siglabsoss/gravpower/ASSY/BOM/Bill of Materials-gravpower.xls

Designator | Description | Manufacturer | Manufacturer P/N | Quantity
C1, C9 | Ceramic Capacitor 47nF ±10% 100V X7R 0805 | Vishay | VJ0805Y473KXB | 2.0
C2, C3, C4, C5, C6, C7, C8 | Ceramic Capacitor 22uF ±20% 100V X7S Stacked | TDK | CKG57NX7S2A226M500JJ | 7.0
C10, C12, C24, C26, C38, C40, C51, C53 | Ceramic Capacitor 1uF ±10% 10V X5R 0402 | Murata | GRM155R61A105KE15 | 8.0
C11, C25, C39, C52 | Ceramic Capacitor 4.7uF ±10% 25V X5R 0603 | Samsung | CL10A475KA8NQNC | 4.0
C13, C14, C15, C16, C29, C30, C43 | Ceramic Capacitor 22uF ±10% 25V X7R 1210 | Murata | GRM32ER71E226KE15 | 7.0
C17, C18, C31, C32, C41, C42 | Tantalum Capacitor 330uF ±10% 10V 2917 | AVX | TPSE337K010R0050 | 6.0
C19, C33, C46, C60 | Ceramic Capacitor 100pF ±1% 50V NP0 0402 | Murata | GRM1555C1H101FA01D | 4.0
C20, C34, C47, C61 | Ceramic Capacitor 100pF ±10% 50V C0G 0402 | Vishay | VJ0402A101KXA | 4.0
C21, C35, C48, C62 | Ceramic Capacitor 1nF ±5% 50V NP0 0402 | Murata | GRM1555C1H102JA01 | 4.0
C22, C36, C49, C63 | Ceramic Capacitor 2.2nF ±5% 25V NP0 0402 | Kemet | C0402C222J3GACTU | 4.0
C23, C37, C50, C64 | Ceramic Capacitor 470pF ±5% 50V X7R 0402 | Murata | GRM155R71H471JA01 | 4.0
C27, C28, C44, C45, C54, C55 | Ceramic Capacitor 22uF ±20% 50V X7S Stacked | TDK | CKG57NX7S1H226M500JJ | 6.0
C56, C57, C58, C59 | Aluminum Electrolytic Capacitor 100uF ±20% 50V | Panasonic | EEE-FTH101XAP | 4.0
D1 | TVS Diode 70V/100V SMA | Diodes Inc | SMAT70A-13-F | 1.0
D2 | Zener Diode 12V 370mW SOD123 | Diodes Inc | DDZ12BQ-7 | 1.0
D3 | TVS Diode 24V/38.9V SMA | Diodes Inc | SMAJ24A-13-F | 1.0
D4, D6, D8, D10 | Schottky Diode 80V 250mA SOD323 | Diodes Inc | 1N4448HWS-7-F | 4.0
D5, D7, D9, D11 | Schottky Diode 200V 10A SMD | Diodes Inc | SBR10U200P5-13 | 4.0
L1, L3, L5, L7 | Inductor 33uH ±10% 500mA SMD | Coilcraft | ME3220-333KL | 4.0
L2 | Inductor 4.7uH,10.5A(sat), SMD | Coilcraft | XAL6060-472ME | 1.0
L4 | Inductor 10uH, 22A(sat), SMD | Pulse Electronics Power | PA4344.103ANLT | 1.0
L6 | Inductor 33uH,3.7A(sat), SMD | Coilcraft | XAL6060-333ME | 1.0
L8 | Inductor 47uH, 8A(sat), SMD | Eaton | HCM1A1707-470-R | 1.0
P1 | 2.5mm pitch 8-position connector | JST | B8B-XH-A | 1.0
P2 | 2.5mm pitch 4-position connector | JST | B4B-XH-A | 1.0
P3, P4 | 2.5mm pitch 5-position connector | JST | B5B-XH-A | 2.0
Q1, Q2, Q3, Q4, Q5, Q6, Q7, Q8, Q9, Q10 | MOSFET N-Channel Enhancement Mode | Infineon | BSC190N15NS3, BSC190N15NS3, BSC050NE2LS, BSC050NE2LS, BSC190N15NS3, BSC190N15NS3, BSC190N15NS3, BSC190N15NS3, BSC190N15NS3, BSC190N15NS3 | 10.0
R1 | Thin Film Resistor 10 Ohm ±1% 0402 | Vishay | MCS04020C1009FE000 | 1.0
R2 | Thin Film Resistor 10k +/-1% SMD 0805 | Yageo | RC0805FR-0710KL | 1.0
R3 | Thin Film Resistor 1k +/-1% SMD 0805 | Yageo | RC0805FR-071KL | 1.0
R4 | Current Sense Resistor 8 mOhms +/-1% SMD 4-Terminal | Susumu | KRL3216T4A-M-R008-F | 1.0
R5 | Thin Film Resistor 2.8k +/-0.1% SMD 0805 | Yageo | RT0805BRD072K8L | 1.0
R6 | Thin Film Resistor 39k +/-0.5% SMD 0402 | Susumu | RR0510P-393-D | 1.0
R7 | Thin Film Resistor 1.37k +/-0.1% SMD 0805 | Yageo | RT0805BRD071K37L | 1.0
R8, R14, R20, R30 | Thick Film Resistor 22.1k ±1% 0402 | Panasonic | ERJ-2RKF2212X | 4.0
R9, R15, R21, R31 | Thick Film Resistor 26.7k ±1% 0402 | Panasonic | ERJ-2RKF2672X | 4.0
R10 | Current Sense Resistor 3 mOhms +/-1% SMD 4-Terminal | Susumu | KRL3216T4A-M-R003-F | 1.0
R11, R17 | Thin Film Resistor 6.8k +/-0.1% SMD 0805 | Susumu | RG2012P-682-B-T5 | 2.0
R12 | Thin Film Resistor 75k +/-0.5% SMD 0402 | Susumu | RR0510P-753-D | 1.0
R13, R19 | Thin Film Resistor 2k +/-0.5% SMD 0402 | Susumu | RR0510P-202-D | 2.0
R16 | Current Sense Resistor 100 mOhms +/-1% SMD 4-Terminal | Susumu | KRL3216T4A-M-R100-F | 1.0
R18 | Thin Film Resistor 22k +/-0.5% SMD 0402 | Susumu | RR0510P-223-D | 1.0
R22 | Thin Film Resistor 430k +/-0.1% SMD 0805 | Yageo | RT0805BRD07430KL | 1.0
R23 | Thin Film Resistor 357k +/-0.1% SMD 0805 | Yageo | RT0805BRD07357KL | 1.0
R24 | Current Sense Resistor 9 mOhms +/-1% SMD 4-Terminal | Susumu | KRL3216T4A-M-R009-F | 1.0
R25 | Thick Film Resistor 10k ±1% 0.1W 50V 0402 | Panasonic | ERJ-2RKF1002X | 1.0
R26 | Thin Film Resistor 15k +/-0.1% SMD 0805 | Susumu | RG2012P-153-B-T5 | 1.0
R27 | Thin Film Resistor 255k +/-0.1% SMD 0805 | Vishay | PTN0805E2553BST1 | 1.0
R28 | Thin Film Resistor 49.9k +/-0.5% SMD 0402 | Susumu | RR0510P-4992-D | 1.0
R29 | Thin Film Resistor 11.5k +/-0.1% SMD 0805 | Yageo | RT0805BRD0711K5L | 1.0
TP1, TP2, TP3, TP4, TP5, TP6, TP7, TP8, TP9 | Test Point SMD | Keystone | 5015 | 9.0
U1 | Ideal Diode Controller | Linear Technology | LTC4359HMS8 | 1.0
U2, U3, U4, U5 | Synchronous Regulator Controller | Linear Technology | LT3840EUFE | 4.0
