siglabsoss/gravpower/SCH/GravPower_SCH.PDF

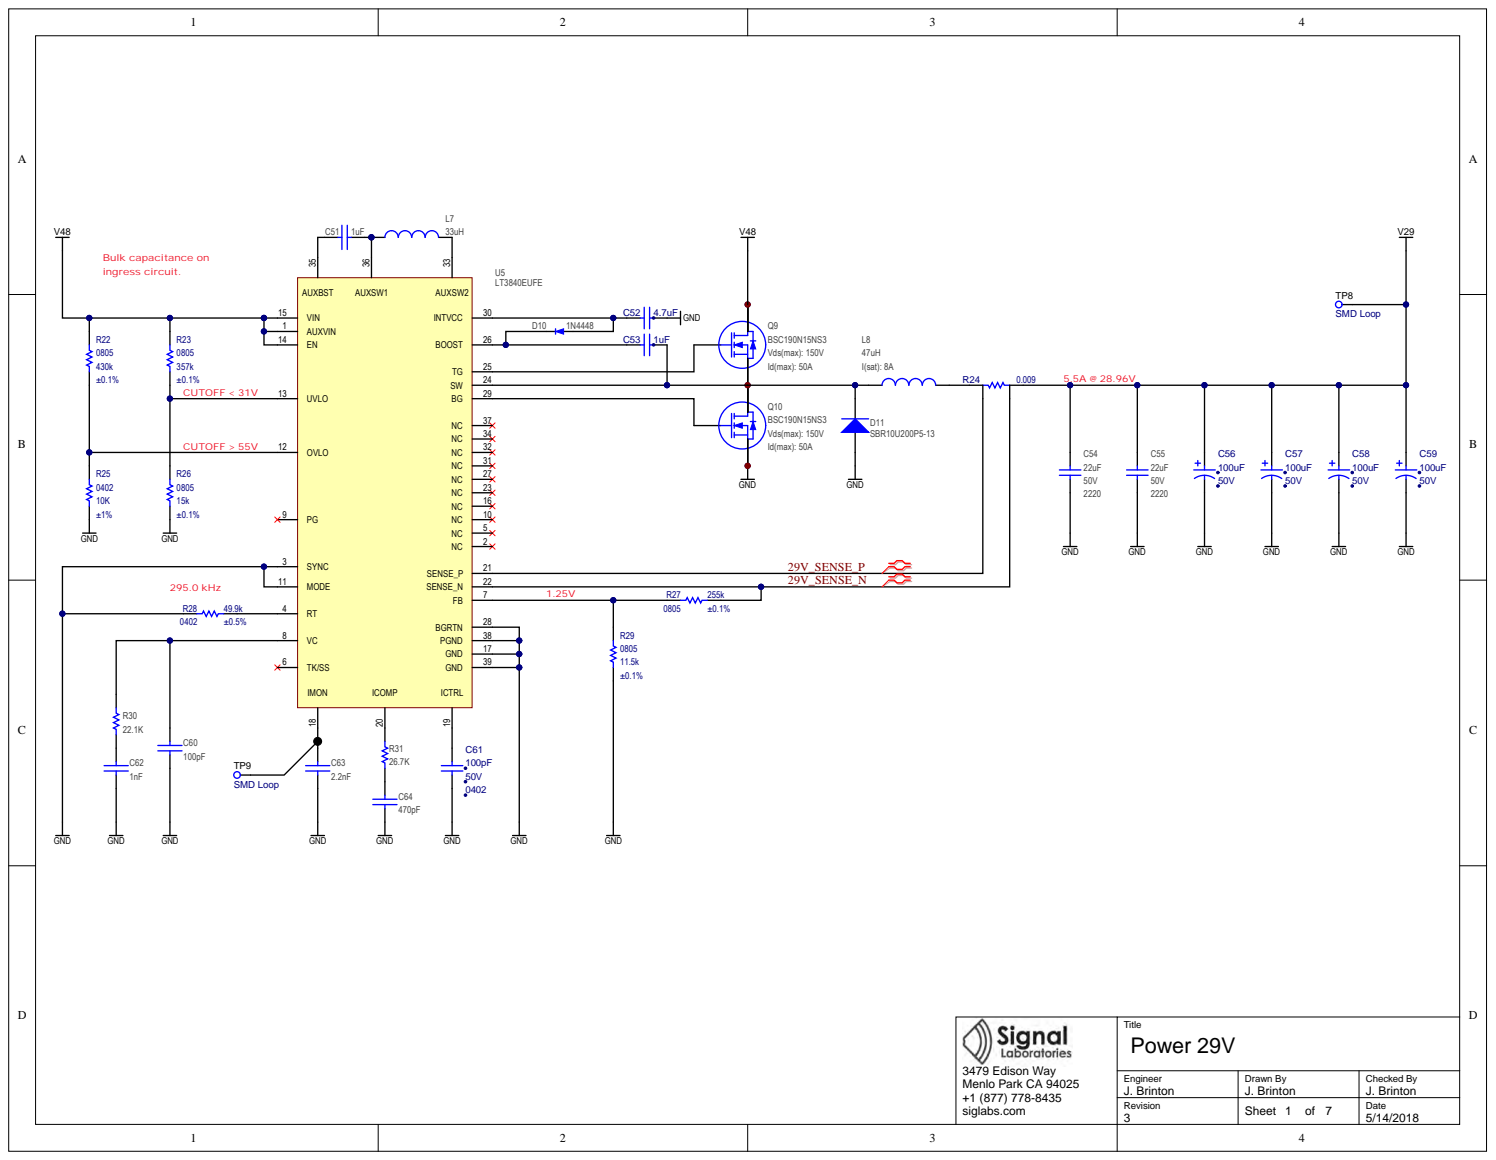
[picture p1: page 1]

R28 49.9k 0402 ±0.5% | MODE 11

3479 Edison Way Menlo Park CA 94025 +1 (877) 778-8435 siglabs.com | Title Power 29V

Engineer J. Brinton | Drawn By J. Brinton | Checked By J. Brinton

of 7 Revision 3 | 5/14/2018 Sheet 1 Date

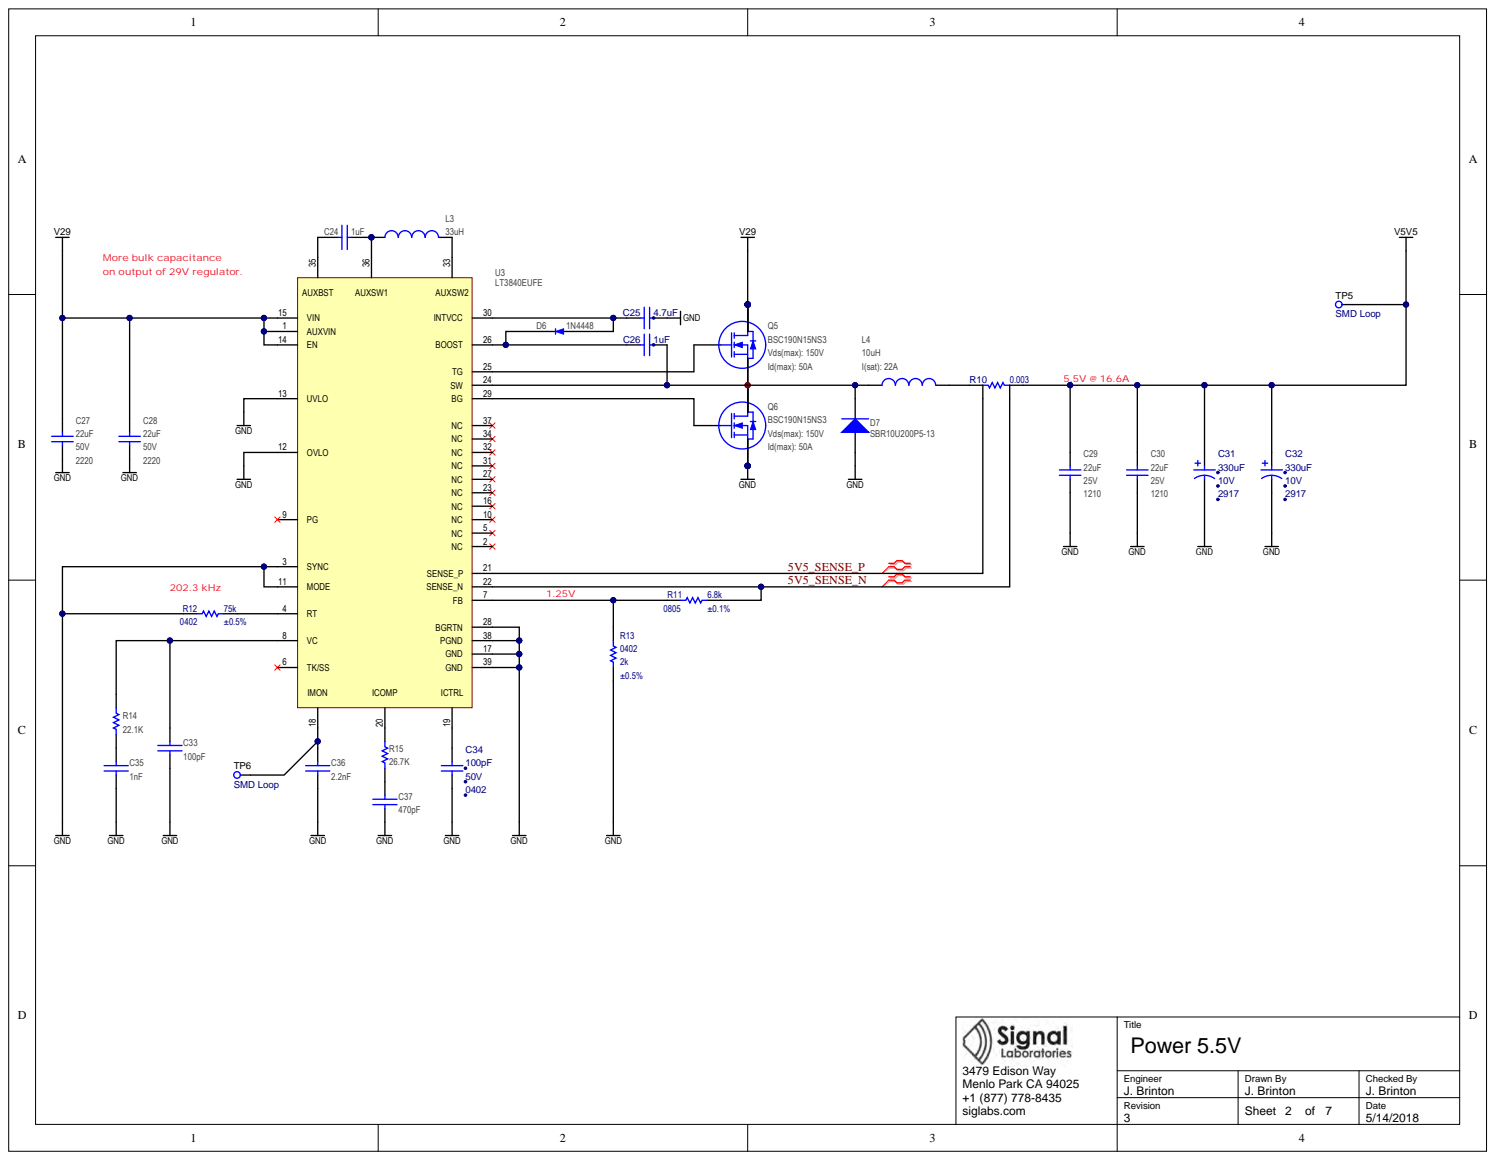
[picture p2: page 2]

More bulk capacitance
on output of 29V regulator.

R12 75k 0402 ±0.5% | MODE 11

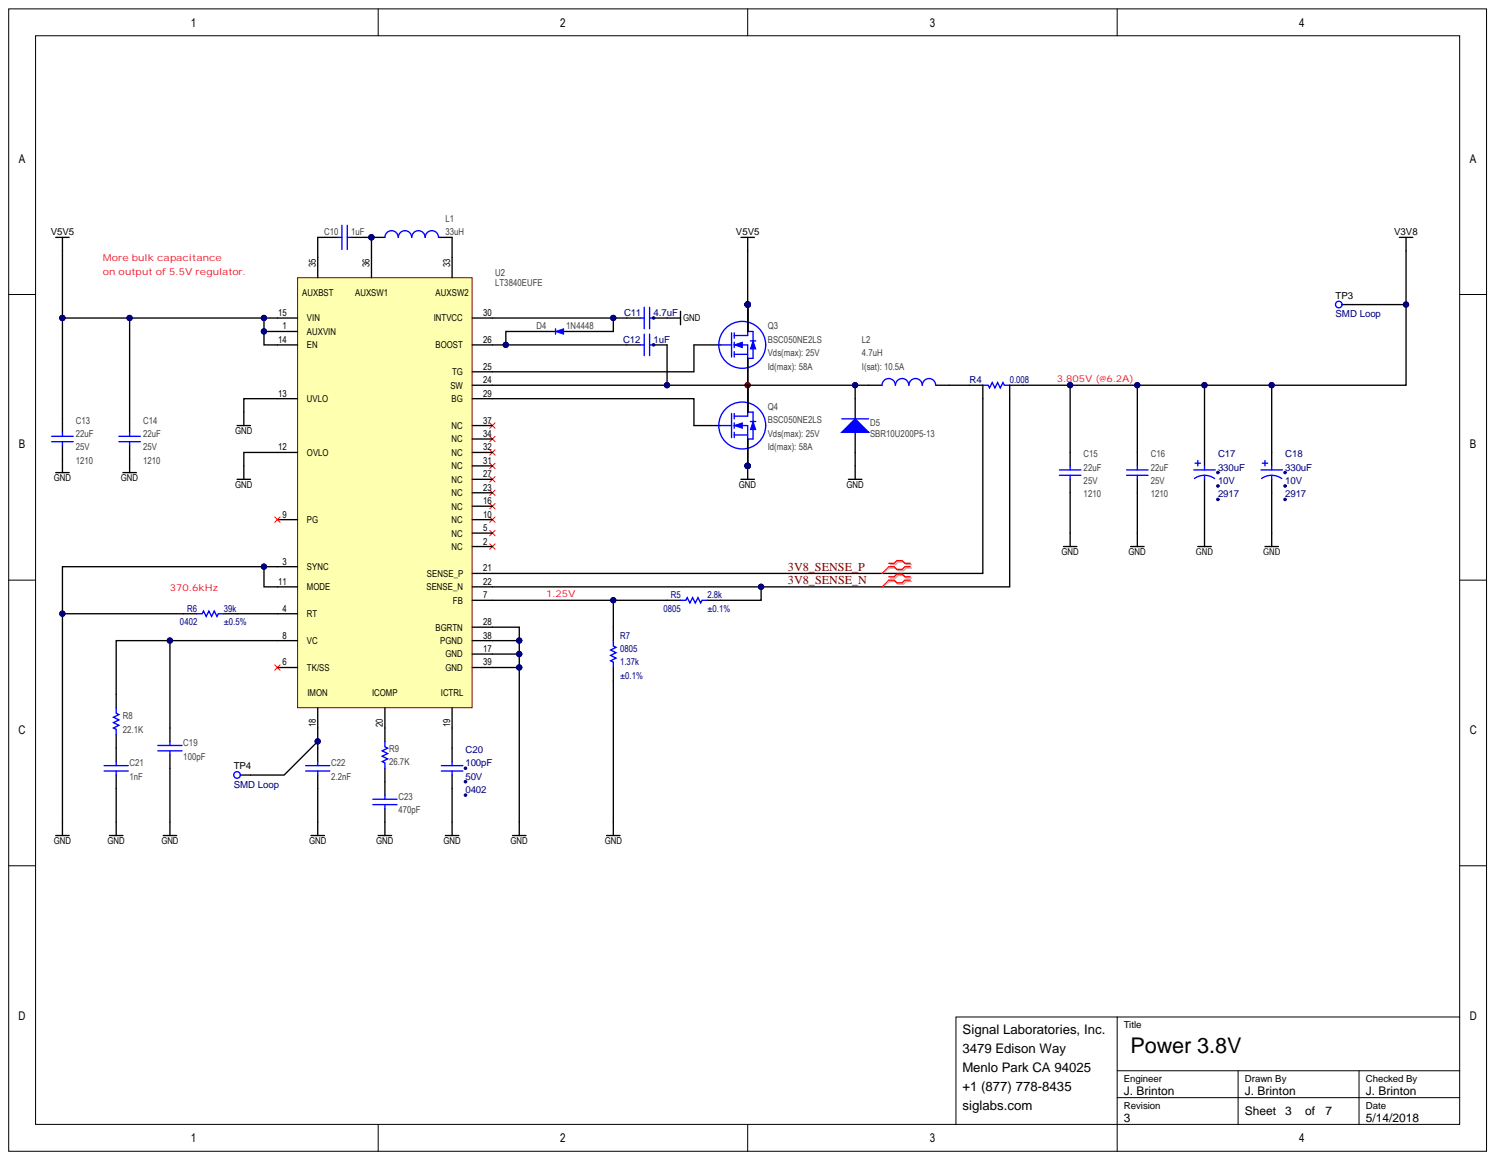
[picture p3: page 3]

More bulk capacitance
on output of 5.5V regulator.

R6 39k 0402 ±0.5% | MODE 11

Signal Laboratories, Inc.
3479 Edison Way Menlo Park CA 94025

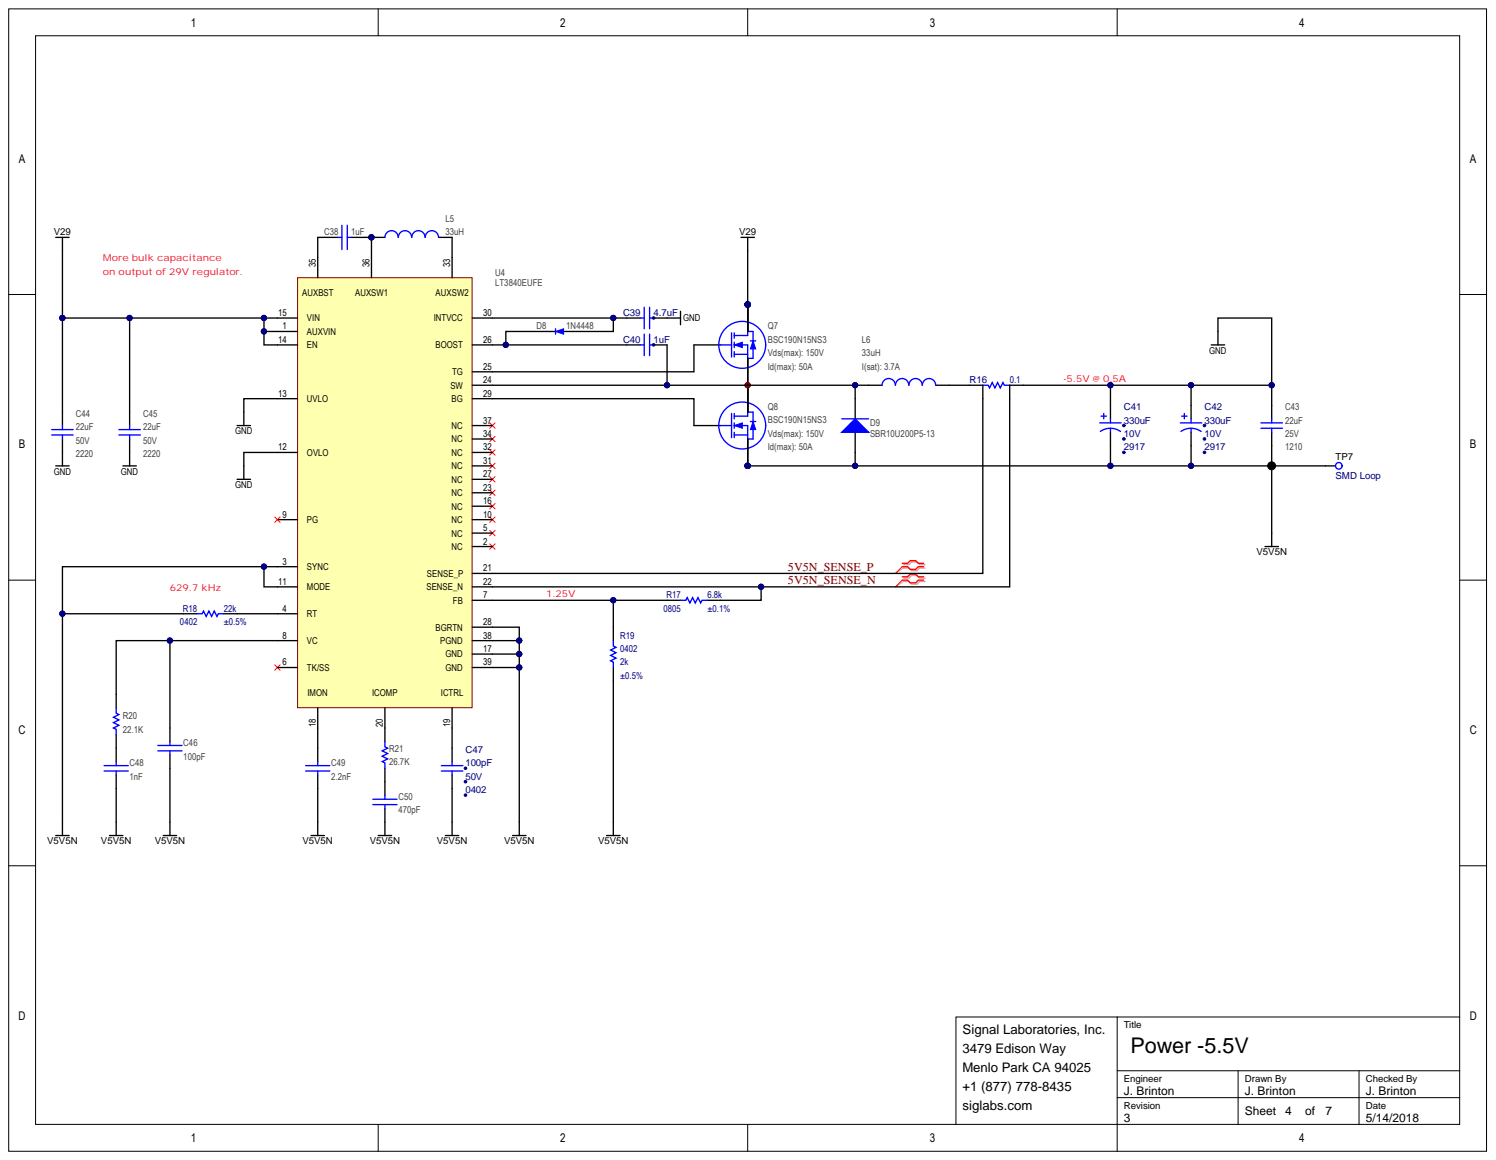
[picture p4: page 4]

More bulk capacitance
on output of 29V regulator.

R18 22k 0402 ±0.5% | MODE 11

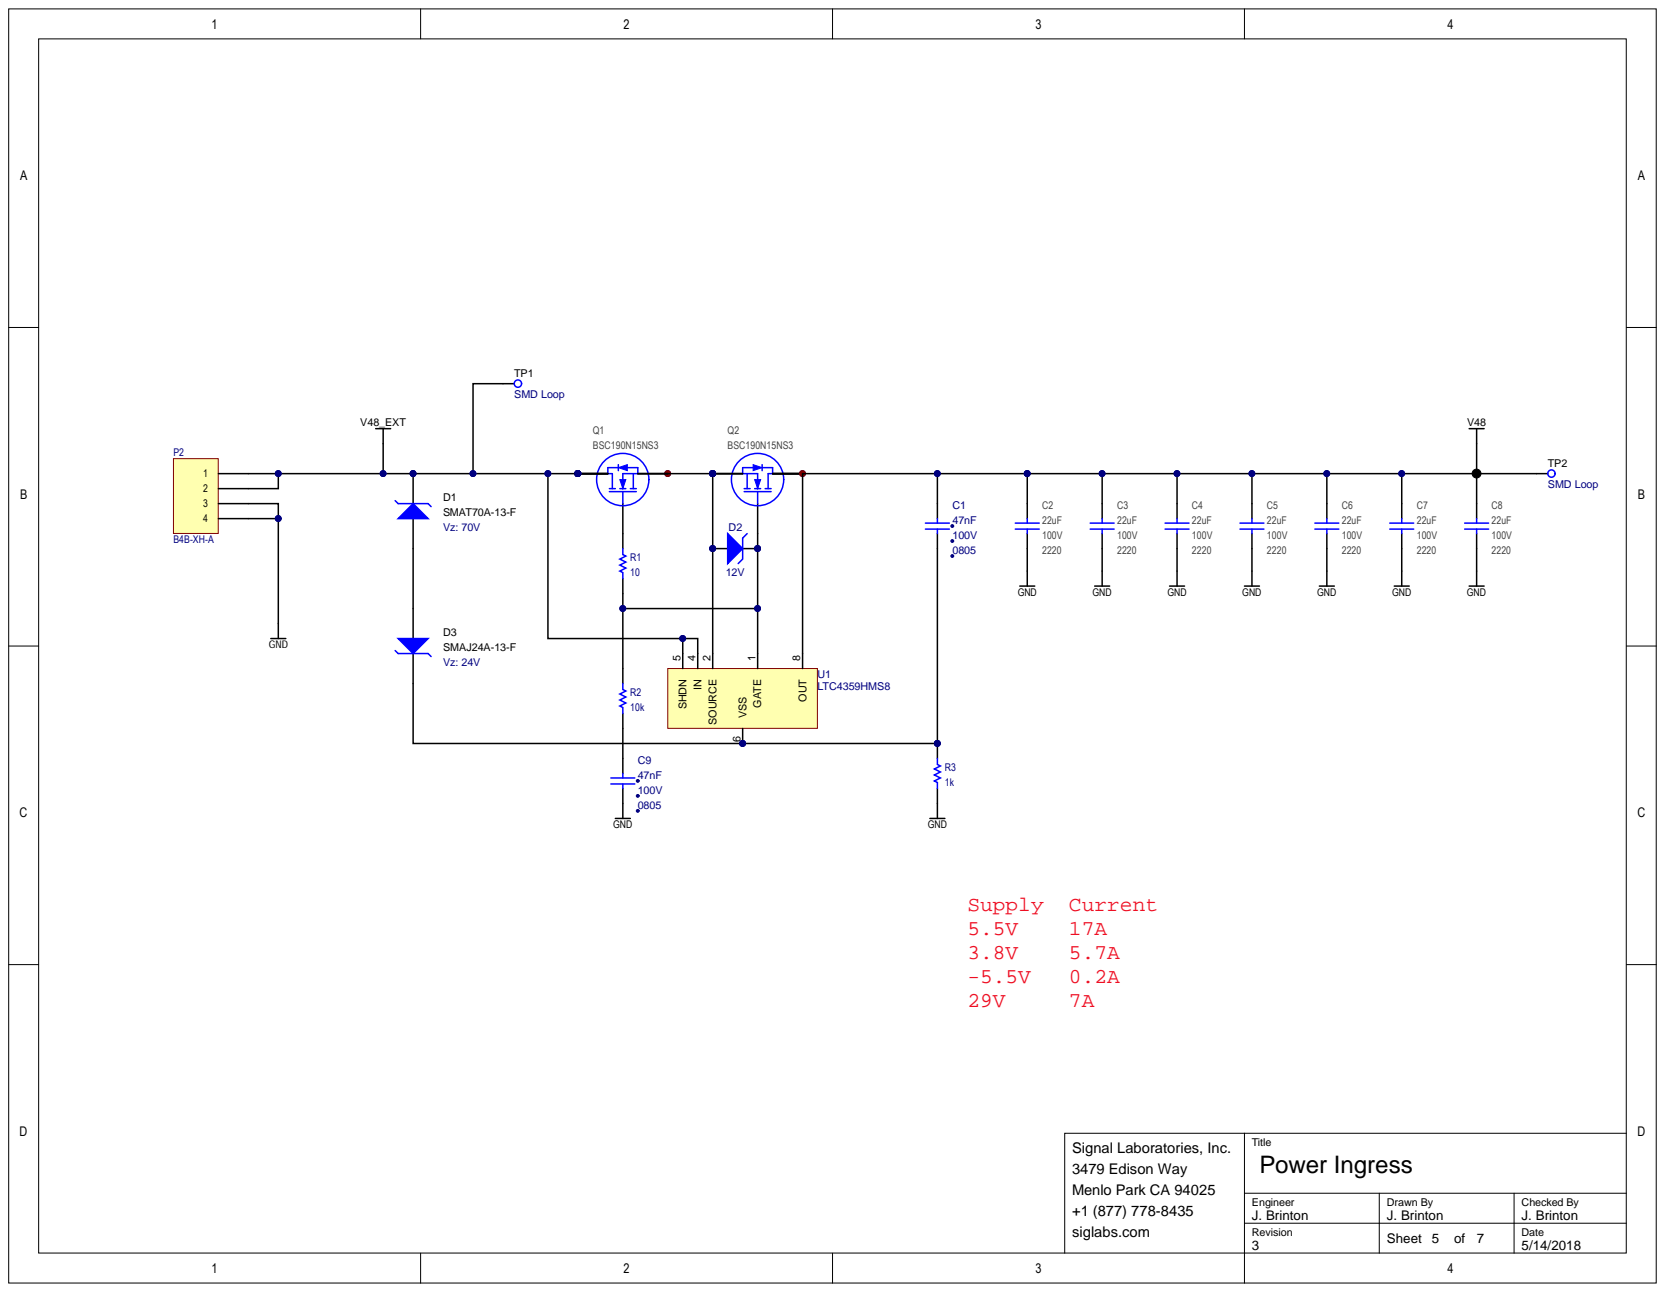
[picture p5: page 5]

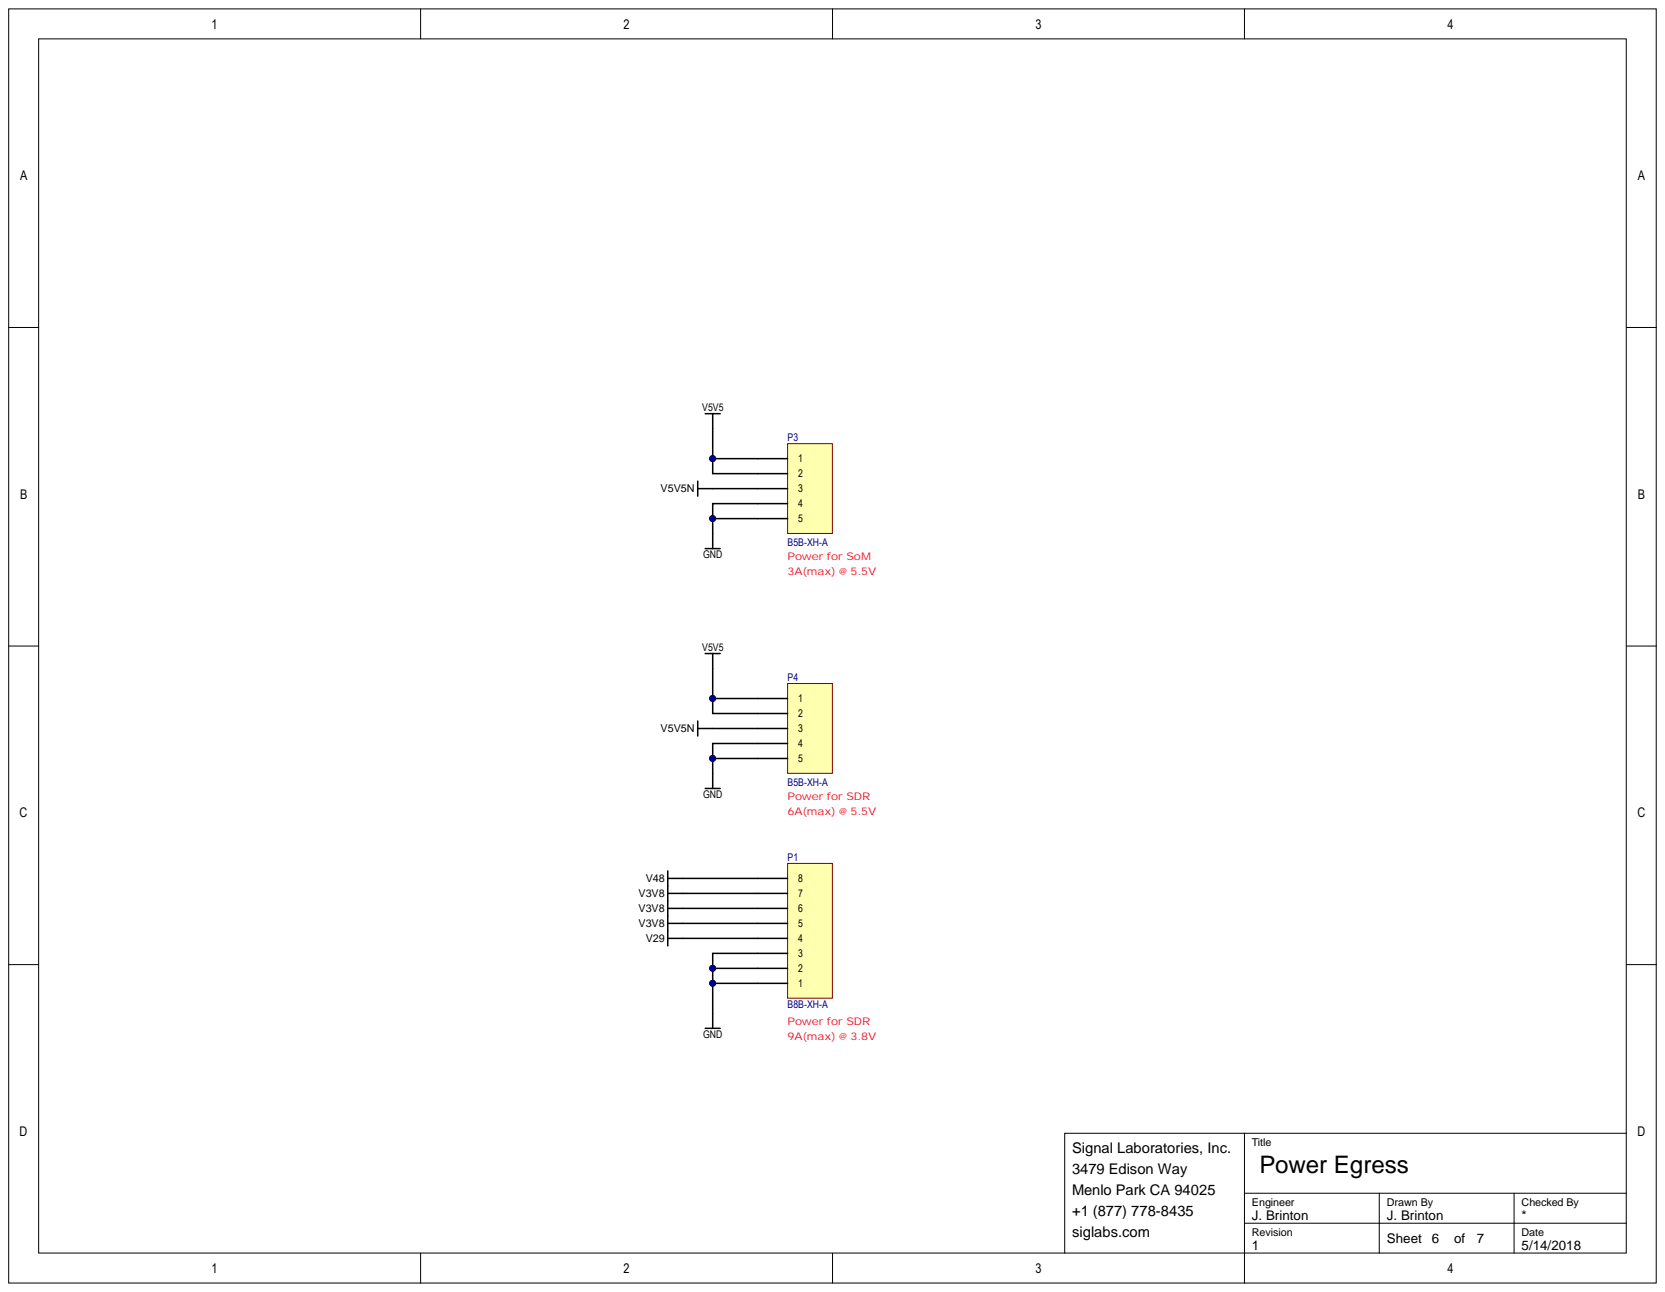
[picture p6: page 6]

Signal Laboratories, Inc. 3479 Edison Way | Title Power Egress

J. Brinton | J. Brinton | *
of 7 Revision | 5/14/2018 Sheet 6

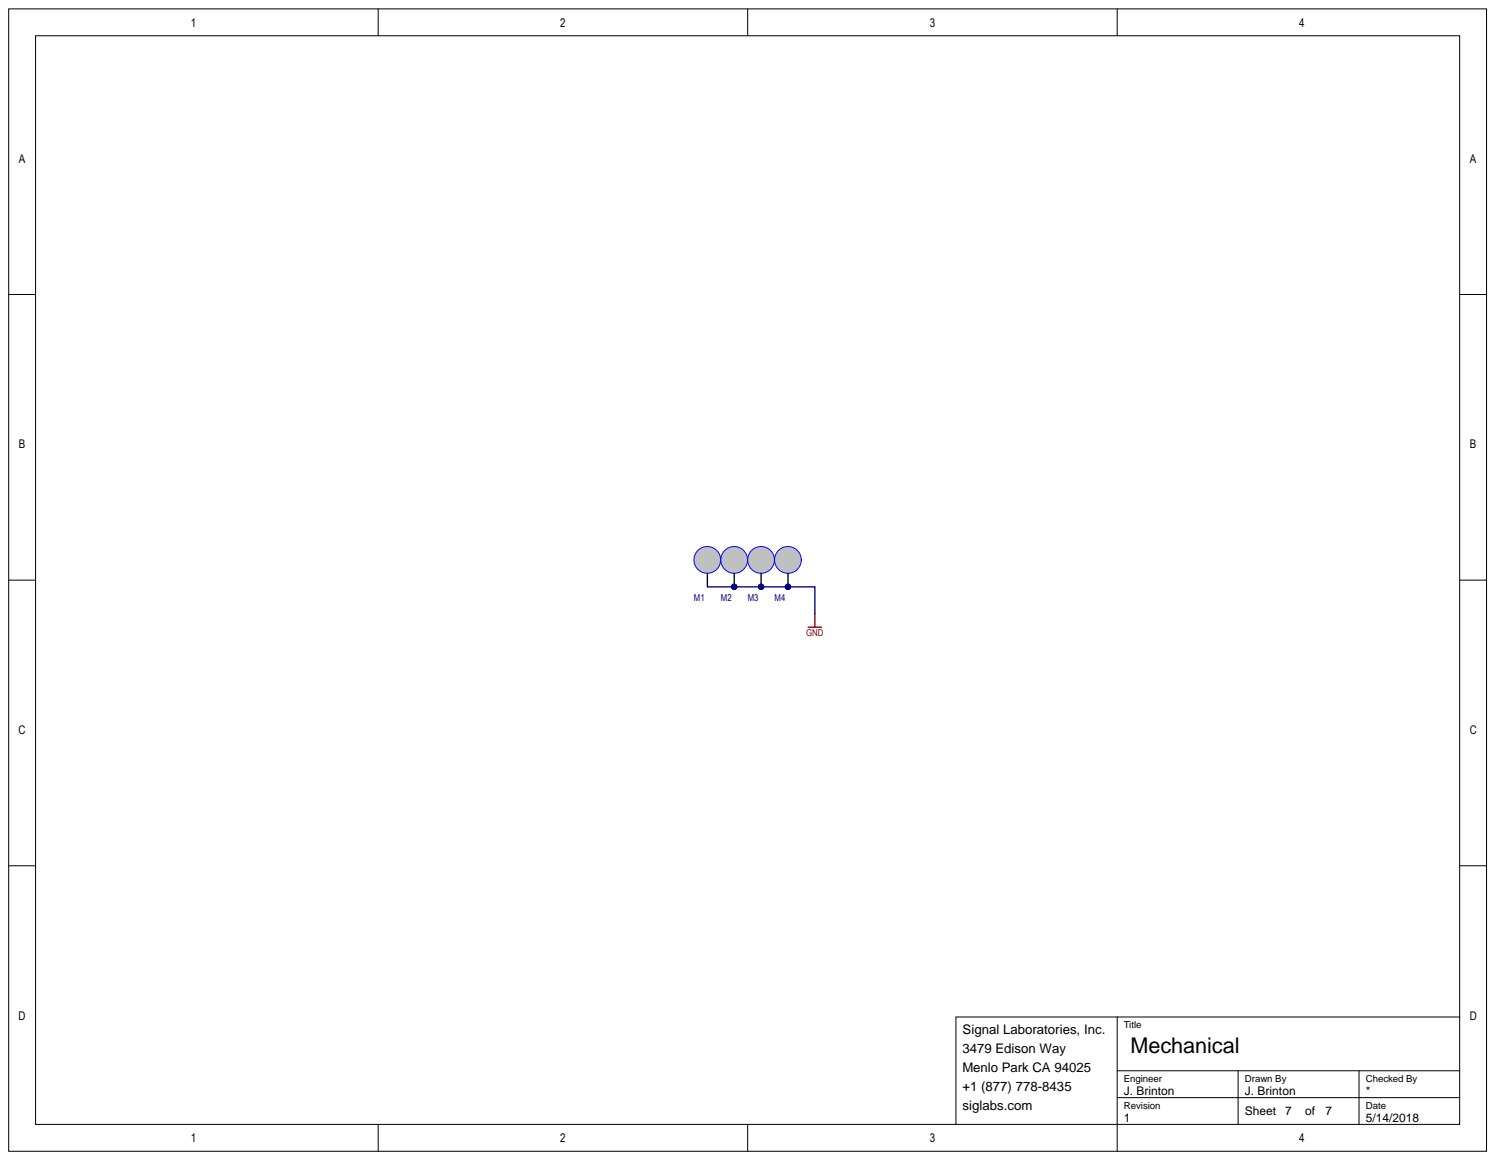
[picture p7: page 7]

Signal Laboratories, Inc. 3479 Edison Way | Title Mechanical

J. Brinton | J. Brinton | *
of 7 Revision | 5/14/2018 Sheet 7
