siglabsoss/gravpower/ASSY/PDF/GravPower_ASY.PDF

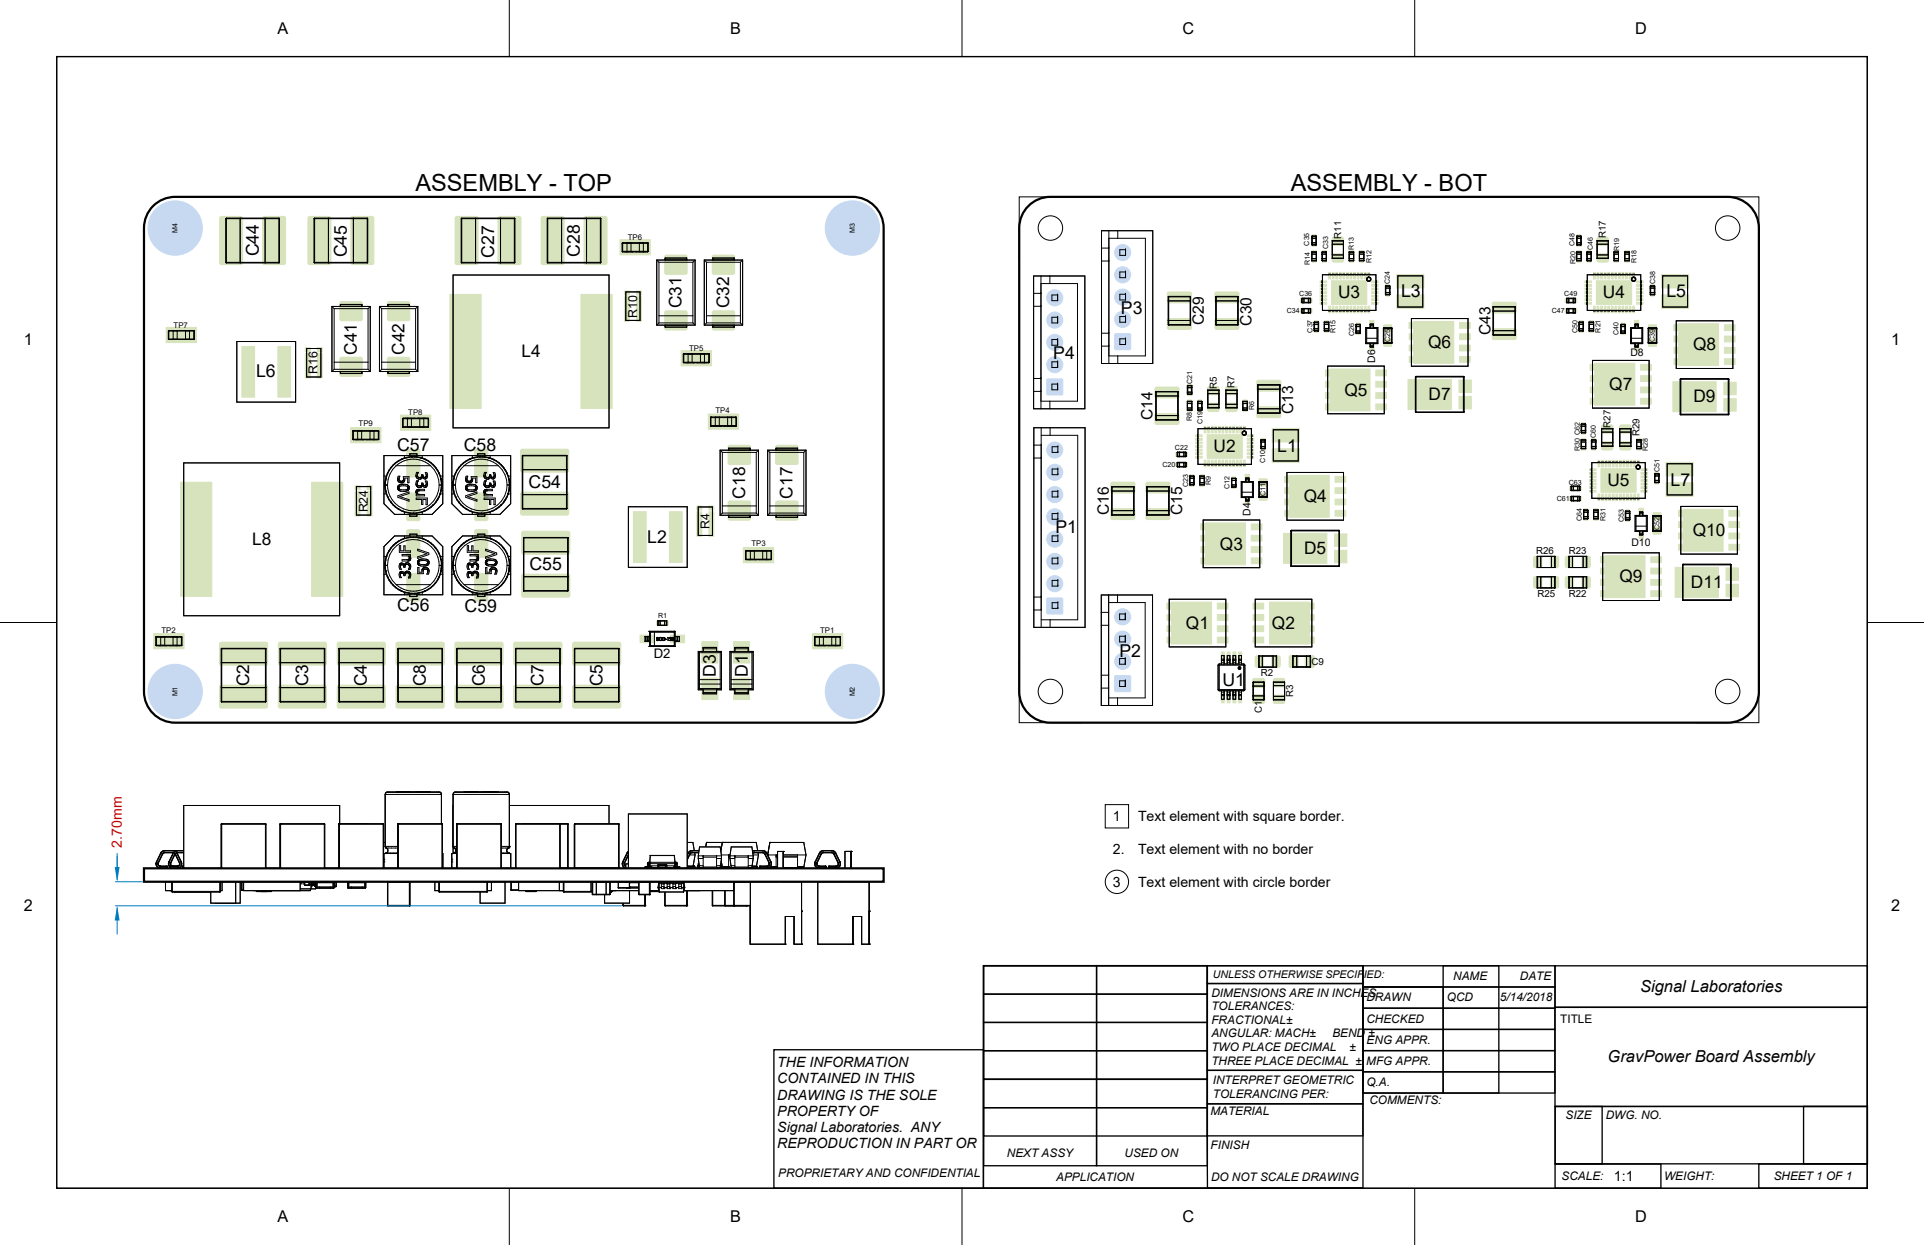
[picture p8: page 1]

2. Text element with no border

3 Text element with circle border

UNLESS OTHERWISE SPECIFIED:
DIMENSIONS ARE IN INCHES
TOLERANCES:
FRACTIONAL±
TWO PLACE DECIMAL ±
THREE PLACE DECIMAL ±
INTERPRET GEOMETRIC
TOLERANCING PER:
MATERIAL

THE INFORMATION
CONTAINED IN THIS
DRAWING IS THE SOLE
PROPERTY OF
Signal Laboratories. ANY
REPRODUCTION IN PART OR
