siglabsoss/gravpower/(list of files, drawings)

Other design files:
egress.SchDoc
gravpower 007.PcbDoc
gravpower.PcbLib
gravpower.PrjPcb
ingress.SchDoc
mechanical.SchDoc
power-v3v8.SchDoc
power-v5v5.SchDoc
power-v5v5n.SchDoc
power-v29.SchDoc
