siglabsoss/gravpower/(commit log)

2018-05-15 first sent to fab
    [Bill of Materials-gravpower.xls, egress.SchDoc, gravpower 007.PcbDoc, gravpower.PcbLib, gravpower.PrjPcb, ingress.SchDoc, mechanical.SchDoc, power-v29.SchDoc]
2018-05-29 rev. 2 as fab'd fixed UVLO pin on 5.5, -5.5, and 3.8V supplies
    [gravpower 007.PcbDoc, gravpower.PrjPcb, power-v3v8.SchDoc, power-v5v5.SchDoc, power-v5v5n.SchDoc]
2018-06-01 load testing worksheet
    [load_worksheet.xlsx]
2018-06-21 updated gravpower solder stencil with less solder in the center pad of the QFN's.
    [gravpower 007.PcbDoc]
